SidhantEE/rubiks-cube-solver/cad/stl/drive_adapter_set.stl

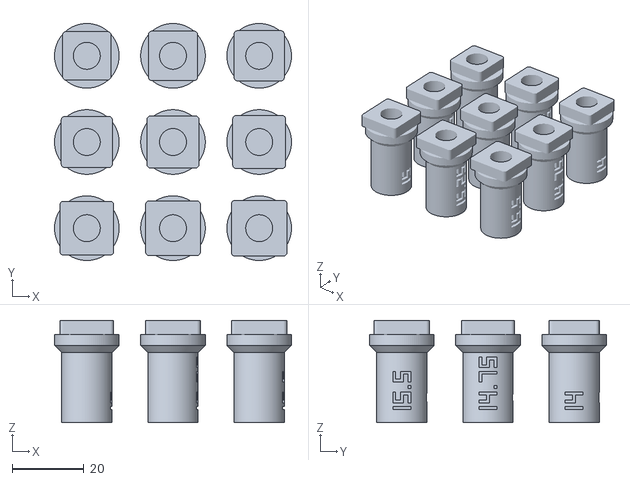
[picture p1: CAD file, 2026-11-10]
cad/stl/drive_adapter_set.stl
66.0 x 66.0 x 28.5
