SidhantEE/rubiks-cube-solver/cad/stl/drive_adapter_PLACEHOLDER_15mm_tip.stl

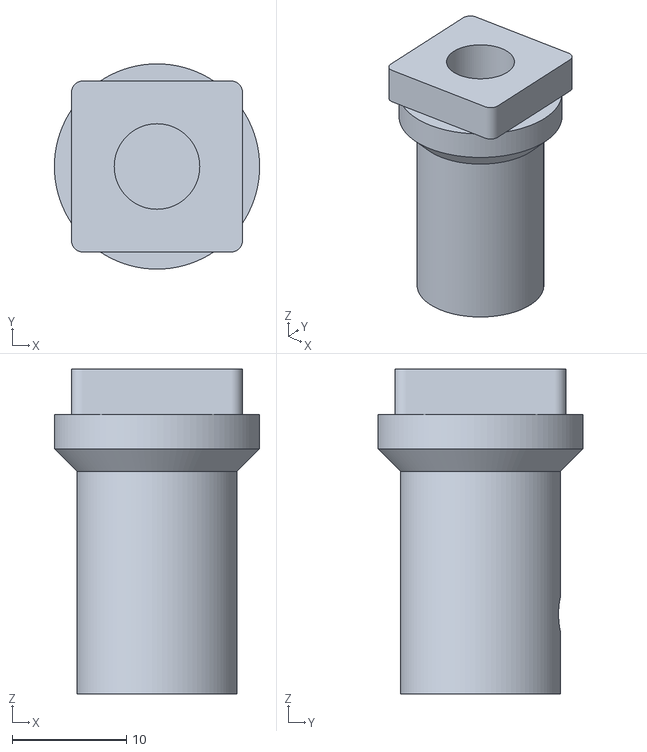
[picture p2: CAD file, 2026-11-10]
cad/stl/drive_adapter_PLACEHOLDER_15mm_tip.stl
18.0 x 18.0 x 28.5
