SidhantEE/rubiks-cube-solver/cad/stl/frame_top.stl

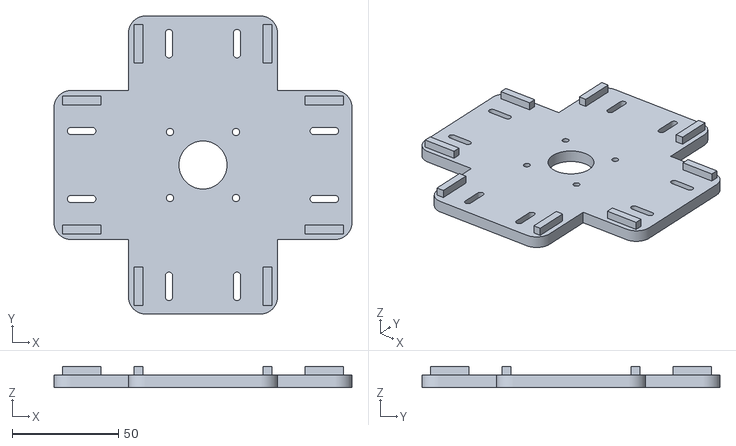
[picture p3: CAD file, 2026-11-10]
cad/stl/frame_top.stl
140.0 x 140.0 x 10.0
