SidhantEE/rubiks-cube-solver/cad/stl/bench_stand.stl

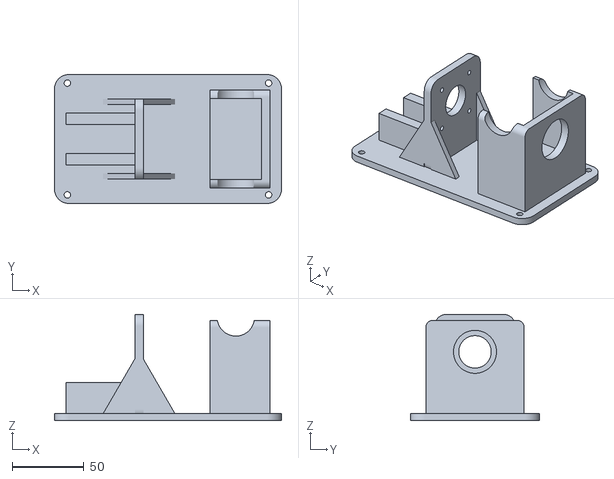
[picture p4: CAD file, 2026-11-10]
cad/stl/bench_stand.stl
158.4 x 90.0 x 74.2
