SidhantEE/rubiks-cube-solver/cad/stl/frame_tower.stl

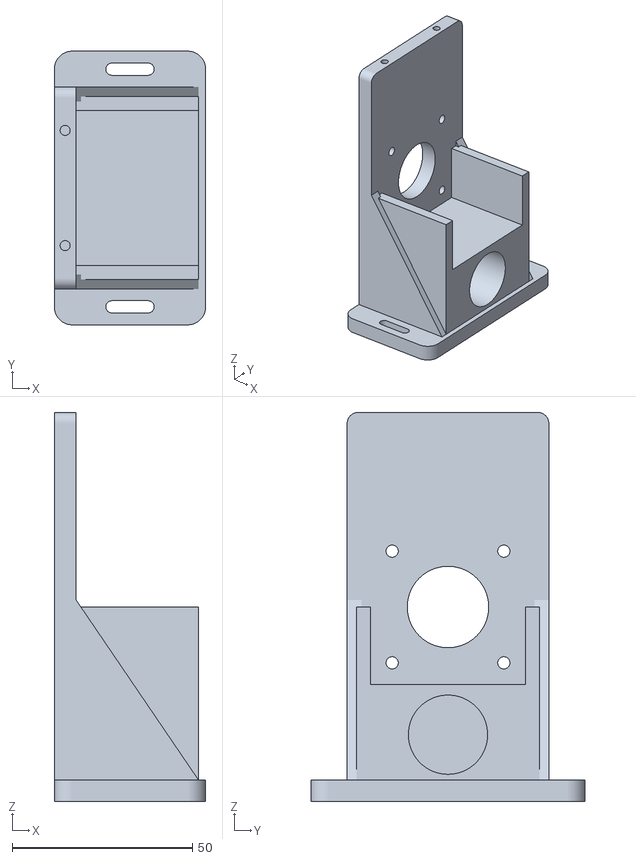
[picture p5: CAD file, 2026-11-10]
cad/stl/frame_tower.stl
42.0 x 76.0 x 108.0
