SidhantEE/rubiks-cube-solver/cad/stl/frame_base.stl

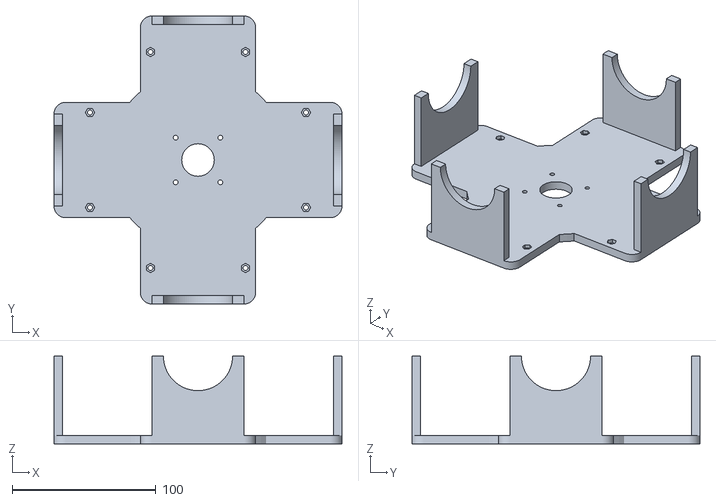
[picture p6: CAD file, 2026-11-10]
cad/stl/frame_base.stl
200.0 x 200.0 x 61.0
