SidhantEE/rubiks-cube-solver/docs/build-plan.html

Research summary and bill of materials · 9 Nov 2026

# What it takes to build a fast Rubik's cube solver

We are building Tier 1: six StepperOnline 17HE19-2004S stepper motors on TMC5160 drivers, about $440 to $460 in parts plus your own 24 V supply, aiming for a solve of 1 to 1.5 seconds. On paper the motor handles 40 to 45 ms quarter turns at 24 V.

The feasibility check is a calculation, not a measurement. No published cube robot names this exact motor, and cube friction is the main unknown. A one-axis bench test settles it before all six axes are built. The parts list below was audited on 10 Nov 2026.

## Where each machine sits

Purdue, Purdubik's Cube (2025)0.103 s

Mitsubishi TOKUFASTbot (2024)0.305 s

MIT, Katz and Di Carlo (2018)0.38 s

Sub1 Reloaded (2016)0.637 s

Flatland and Rose, steppers (2016)0.900 s

Hackaday build, Aaed Musa (2023)4.56 s

Tier 1, steppers (our build)1 to 1.5 s

Tier 2, brushless servos0.3 to 0.6 s

Tier 3, industrial servos0.1 to 0.15 s

0.1 s0.20.5125 s

Logarithmic scale. Dots are recorded times. Blue bands are estimated ranges for the three build tiers below.

## Tier 1 motor choice

The pick is the StepperOnline 17HE19-2004S, chosen on price. At $6.36 it is the cheapest of the four, and it has lower winding inductance than the motor the Hackaday build used. Inductance is what starves a stepper of torque at speed. The LDO is the faster motor at five times the price.

Motor | Holding torque | Current | Inductance | Rotor inertia | Price each
StepperOnline 17HE19-2004S (chosen) | 0.55 Nm | 2.0 A | 2.4 mH | 62 g·cm² | $6.36
StepperOnline 17HS19-2004S1 (Hackaday motor) | 0.59 Nm | 2.0 A | 3.0 mH | 82 g·cm² | $9.62
LDO-42STH48-2504AC | 0.55 Nm | 2.5 A | 1.5 mH | 84.5 g·cm² | $32.99
ADI Trinamic QSH4218-47-28-040 | 0.40 Nm | 2.8 A | 0.6 mH | 68 g·cm² | about $60
StepperOnline 23HS22-2804S (NEMA 23) | 1.26 Nm | 2.8 A | 2.5 mH | not found | about $25

Specs are from the manufacturers' pages and spec sheets. StepperOnline and LDO prices were read from the store pages on 9 Nov 2026; StepperOnline prices ship from China, and US stock adds about $2 to $3.50 a motor. The Trinamic price is for a sibling model at Mouser. All three NEMA 17 motors share the same 42 mm body, 48 mm length and 5 mm shaft, so printed parts fit any of them.

### Which motors have been documented in a cube solver

- 17HS19-2004S1: yes. The Hackaday build's parts list links to this exact motor. It solved in 4.56 s, held back by weak TMC2208 drivers and a 75-move solver.
- 17HE19-2004S (our pick): no cube solver names it. It is common in hobby CNC builds. Its wire colours differ from the 17HS19, and one builder had to swap the blue and green wires.
- LDO-42STH48-2504AC: no cube solver names it. It is a standard high-speed 3D-printer motor.
- Other fast stepper robots (0.900 s and 1.5 to 2 s) do not publish their motor models.

## Will it work?

### Yes on paper, for quarter turns of 40 ms and slower at 24 V

At 24 V the 17HE19-2004S has roughly 1.5 to 2.6 times the torque a 40 ms quarter turn needs. At 35 ms it has no margin on 24 V, but a 35 V supply restores it. About 20 moves at 40 to 45 ms is 0.8 to 0.9 s of motion.

### Torque needed against torque available

Quarter turn | Peak speed | Torque needed | Available at 24 V | Available at 35 V | Verdict
50 ms | 600 rpm | 0.10 to 0.20 Nm | 0.47 Nm | 0.55 Nm | comfortable
45 ms | 667 rpm | 0.12 to 0.22 Nm | 0.41 Nm | 0.55 Nm | comfortable
40 ms | 750 rpm | 0.13 to 0.23 Nm | 0.34 Nm | 0.55 Nm | works at 24 V
35 ms | 857 rpm | 0.16 to 0.26 Nm | 0.26 Nm | 0.51 Nm | needs about 35 V
30 ms | 1,000 rpm | 0.20 to 0.30 Nm | 0.17 Nm | 0.41 Nm | marginal at 35 V

My calculation. Assumes a cube layer of 150 g·cm² (a commenter's estimate on the MIT build log, close to my own), friction of 0.05 to 0.15 Nm (a guess), and a move that accelerates for half the turn and brakes for the other half. "Available" is the theoretical pull-out torque at peak speed; an open-loop stepper should stay well under it. The rotor inertia is 62 g·cm², from the motor's datasheet. The cube weighs 88.9 g, which puts one layer at roughly 145 g·cm², in line with the 150 used here. For comparison at 40 ms on 24 V, the same sum gives the LDO 0.48 Nm and the Hackaday motor 0.27 Nm.

### Evidence from other builds

- Same timing has been done with steppers. Flatland and Rose's 0.900 s record robot used six steppers at 50 full steps per quarter turn. Their published timing tables give 35 ms per quarter turn and 56 ms per half turn at the fastest setting, about 0.90 s for 25 moves. Their motor model is not published.
- Generic steppers reach 1.5 to 2 s. iBoot32's 2022 robot did that with DRV8825 drivers, which are weaker than the TMC5160.
- Too little torque fails outright. A University of Illinois team's 0.10 Nm NEMA 14 motors could not turn a face at all. Our motor has 5.5 times that at standstill.
- No precedent for this exact motor. I read nine hobby cube robots and searched by part number. None names the 17HE19-2004S, and most name no motor.

### What could still stop it

- Cube friction. Nobody publishes a measured turning torque for a speed cube. A cube tensioned tight enough not to deform may need more than my 0.15 Nm upper guess.
- Lock-ups. If one face stops a few degrees off, the next turn jams. An open-loop stepper then loses steps without knowing. The MIT team blew drive transistors this way.
- Driver heat. The TMC5160 board needs a fan above 2 A. This motor runs at 2.0 A, right at that limit, and you have chosen to run without a fan. If a driver overheats it cuts the motor current, which shows up as missed turns in long runs.
- Driver voltage ceiling. The standard TMC5160 board stops at 35 V, so a 36 V supply must be trimmed down to about 33 V.

## What actually sets the solve time

Solve time is roughly the number of moves multiplied by the time per move, plus a few tens of milliseconds for the camera and solver. Both factors differ by about a factor of ten between the Hackaday build and the record.

Machine | Solver | Moves | Per quarter turn | Actuator
Hackaday build | CFOP (human method) | 50 to 75 | about 92 ms | Open-loop NEMA 17 stepper, one at a time
MIT 2018 | min2phase | 19 to 23 | 10 ms, one every 15 ms | Kollmorgen ServoDisc, 2000-line encoder, 40 V
Mitsubishi 2024 | Proprietary | about 15 | 9 ms | Mitsubishi servomotors, model not published
Purdue 2025 | rob-twophase | not published | about 5.5 ms (my estimate) | Kollmorgen AKM2G-24F

- Solver: switching from CFOP to a two-phase solver cuts 75 moves to about 20. It is free software and the largest single gain.
- Parallel moves: rob-twophase counts opposite faces turning together as one move, averaging about 15 moves, found within 10 ms.
- Torque over inertia: quarter-turn time depends on how hard the motor can accelerate its own rotor plus one cube layer. This is where steppers lose.
- Corner cutting: starting the next face before the last one has stopped. It needs closed-loop position feedback and breaks cubes when mistimed.
- The cube: at record speed, stock cubes snap. Purdue used a custom SLS nylon core tensioned too tight to turn by hand.

## The record machine, part by part

Part | What Purdue used | Confidence
Motors | 6× Kollmorgen AKM2G-24F | One trade article names it; its quoted 3,400 rpm matches the datasheet
Drives | Kollmorgen AKD2G | Kollmorgen's own promotion; exact variant not published
Controller | Kollmorgen PCMM2G | Kollmorgen's own promotion
Cameras | 2× Flir machine vision, 10 µs exposure, 128×124 px crop | One article; model not published
Colour reading | Raw RGB values, no image processing | One article
Solver | rob-twophase (Elias Frantar) | One article, links the repo
Cube | Custom SLS nylon core, lubricated, very high tension | Two articles
Motion | Trapezoidal profile, about 12 million °/s², corner cutting | One article
Compute, 103 ms breakdown | Not published | Not found

### AKM2G-24F datasheet figures

Frame | 58 mm flange, about 2.0 kg
Continuous stall torque | 1.86 Nm
Peak torque | 7.24 Nm
Rotor inertia | 0.279 kg·cm²
Peak torque ÷ rotor inertia | about 260,000 rad/s² (15 million °/s²)
Rated speed | 3,400 rpm at 120 VAC, 7,200 rpm at 240 VAC
Max mechanical speed | 8,000 rpm
Paired drive in the guide | AKD2G-SPx-6V06 (6 A, 120/240 VAC)

From Kollmorgen's AKM2G selection guide. The trade article calls the motors "low-voltage" and quotes 5.97 Nm, but the low-voltage catalogue has no F winding and 5.97 Nm belongs to the 24PL. I believe the model is right and that label is wrong.

## Three build tiers

listed price seen on a seller page this week estimate my rough figure, check before buying unknown no price found

### Tier 1: stepper build (chosen)

target 1 to 1.5 s · about $440 to $460

The Hackaday layout with stronger drivers, a two-phase solver, a real speed cube and cameras. At 40 to 45 ms per quarter turn and about 20 moves, motion takes 0.8 to 0.9 s. This list was audited on 10 Nov 2026 against the carts and the parts' own datasheets.

### Ordered

Item | Qty | Each | Subtotal | Price basis
StepperOnline 17HE19-2004S stepper motor, US warehouse | 6 | $8.45 | $50.70 | seen in your StepperOnline checkout
StepperOnline packing fee | | | $1.90 | seen in your StepperOnline checkout
TMC5160 SilentStepStick driver | 7 | $19.20 | $134.40 | seen in your Mouser cart; six for the build, one spare
Teensy 4.1 with headers (SparkFun DEV-16996) | 1 | $35.95 | $35.95 | seen in your Mouser cart
Jumper wires, 6", packs of 20 (male-female and female-female) | 2 | $2.75 | $5.50 | seen in your Mouser cart
22 AWG stranded wire, black, 25 ft | 1 | $5.95 | $5.95 | seen in your Mouser cart
Mouser estimated tariff | | | $12.88 | seen in your Mouser cart
Mouser UPS Ground shipping | | | $9.39 | seen in your Mouser cart
YJ YuLong V2 M speed cube | 1 | $8.99 | $8.99 | listed price I did not see how many you ordered
Cubicle Silicone Lube, Weight 3, 5cc | 1 | $3.89 | $3.89 | listed price I did not see it in a cart
Ordered subtotal | | | $269.55

I saw the carts but not the final orders, so three things may differ. If you swapped to the motor 5-pack plus one single, motors are about $6.78 less. If you added the red wire, add $5.95. Shipping from StepperOnline and TheCubicle, and sales tax, are not included.

### Still to buy

Item | Qty | Subtotal | Price basis
100 µF 50 V capacitors, one per driver | 7 | $3 to $5 | estimate
M3 screws: 24 × 10 mm for the motors, 6 × 6 mm for the adapters | 1 box | $8 to $10 | estimate an assortment box covers both
Screw terminals or protoboard for the 24 V wiring | 1 | $5 to $10 | estimate
Micro-USB cable for the Teensy | 1 | $0 to $5 | estimate the board does not include one
Printed bench stand, UTA FabLab | 1 | about $5 | estimate from the model at $0.05 per gram
Printed six-motor frame and six shaft adapters | 1 set | $15 to $17 | estimate from the models at $0.05 per gram
Arducam colour global-shutter USB camera (OV9782) | 2 | $120 | estimate mono version listed at $60
LED lighting for the cameras | 1 | $10 to $15 | estimate
24 V power supply, about 10 A for six motors | 1 | not included | You are supplying this
Still-to-buy subtotal | | $166 to $187
Whole Tier 1 build | | $436 to $457 | Without cameras and lighting: $306 to $322

### What the audit changed

- Drivers: six became seven, matching what is in the cart.
- Fan: removed, as you decided it is not needed.
- Motor price: now the $8.45 US-warehouse price from your checkout, plus the packing fee.
- Added: Mouser's tariff and shipping, the wires, the lube, M3 screws, a USB cable and the printed parts. None of these were in the earlier list.
- Split in two: the old single "wiring and lighting" and "frame and fasteners" estimates are now separate lines.

### Checks against the parts' own documents

- Motor: the 17HE19-2004S datasheet confirms 0.55 Nm, 2.0 A, 1.30 Ω, 2.40 mH, a 62 g·cm² rotor and 0.27 kg. Its drawing confirms a 5 mm shaft 24 mm long with a 15 mm flat, M3 holes on a 31 mm square and a 22 mm boss.
- Motor cable: 1 m of 24 AWG wire ending in a 4-pin 2.54 mm plug. The wires run B−, A−, B+, A+, which does not match the driver's pin order, where each coil's two pins sit together. Two pins have to be moved in the plug before it goes on the driver.
- Driver and motor: the driver's 3 A and 10 to 35 V limits cover the motor's 2.0 A on a 24 V supply.
- Driver and Teensy: both use 3.3 V logic. The driver must be set up over SPI.
- Firmware: the Teensy sketch in the repository sets each driver to 2.0 A over SPI, uses 8 microsteps (400 steps per quarter turn) and turns opposite faces together. It passes a simulated test on a computer; it has not run on real hardware.
- Driver header pins: I have not confirmed whether the board arrives with its pins soldered. Plan on a soldering iron being needed.
- Cube: TheCubicle lists it at 56.0 mm and 88.9 g, magnetic.

### Where to buy

Part | Mouser | Otherwise
Teensy 4.1 | Yes. With headers (DEV-16996) is $35.95, 361 in stock. The bare board (DEV-16771) is restricted. | SparkFun, $31.50 for the bare board
TMC5160 SilentStepStick | Yes, 620 in stock; Mouser will drop it when stock runs out | DigiKey
Mean Well LRS-350-24 | Yes, 362 in stock | Bravo Electro, Jameco
17HE19-2004S motor | No. Mouser carries no StepperOnline parts | StepperOnline direct, or its Amazon store
Arducam camera | Not found | Arducam, RobotShop
Speed cube, filament, fasteners, magnets | No | Cube shops, Amazon, hardware suppliers

The drivers, the Teensy and a power supply can come from Mouser. The motors, cube and cameras cannot. Its own NEMA 17 motors start at $32.81 and are low-current types that suit this job poorly. Mouser stock and prices were read from the live pages on 9 Nov 2026.

### Tier 2: brushless servo build

target 0.3 to 0.6 s · about $1,300 to $2,100

The MIT approach with current off-the-shelf parts: six brushless motors with encoders and closed-loop field-oriented drivers. The motor choice below is a starting point. Its rotor inertia is not published where I looked, so one axis needs testing before buying six.

Item | Qty | Each | Subtotal | Price basis
mjbots mj5208 brushless motor | 6 | $74 | $444 | listed reseller
moteus-c1 controller (or moteus-n1 at $149) | 6 | $69 to $149 | $414 to $894 | listed reseller
CAN-FD USB adapter | 1 | $100 | $100 | estimate
48 V supply, 600 to 1,000 W, plus bulk capacitors | 1 | $60 to $120 | $60 to $120 | estimate
Colour global-shutter USB camera | 2 | $60 | $120 | estimate
Speed cubes (expect to break several) | 5 | $10 to $20 | $50 to $100 | estimate
Square drives and shaft couplers | 6 | | $40 to $100 | estimate
Rigid frame, aluminium plate or extrusion | 1 | | $100 to $200 | estimate
Total | | | $1,328 to $2,078

Alternative drivers: ODrive Micro at $89 or ODrive Pro at $229 each (listed). A one-axis starter is the moteus-c1 developer kit at $149 (listed), which includes one mj5208 motor.

### Tier 3: industrial servos, the record recipe

target 0.1 to 0.15 s · $33,000 and up

The Purdue hardware. Students built it with corporate sponsorship and co-op earnings, and it also needs a custom cube core.

Item | Qty | Each | Subtotal | Price basis
Kollmorgen AKM2G-24F motor | 6 | about $2,475 | about $14,850 | estimate reseller price of the older AKM24D
Kollmorgen AKD2G-SPE-6V06S drive | 6 | $3,035 | $18,210 | listed reseller
Kollmorgen PCMM2G controller | 1 | | | unknown
Flir machine-vision cameras | 2 | | | unknown model not published
Custom SLS nylon cube core, machined shafts, frame | 1 | | | unknown
Motors and drives only | | | about $33,060

## What I would do

### Build Tier 1, and bench-test one axis before buying six motors

The solver, camera reading, move scheduler and cube handling are the same work at every tier. Building them on steppers gets a working machine near 1 second, and a later brushless upgrade replaces only the actuators and their drivers.

1. Solver on your computer. Build rob-twophase and get from a scramble to a move list. Free, and it works before any hardware arrives.
2. One axis on a bench. One 17HE19-2004S motor and one TMC5160 on 24 V, turning one face of a tensioned speed cube. Start at 60 ms per quarter turn and shorten it until steps are lost. If it holds 40 to 45 ms, order the other five.
3. Six axes with manual entry. Frame, six motors, a move scheduler. Type in the cube state and solve it.
4. Parallel opposite faces. Run the two motors on an axis together, using the solver's axial mode.
5. Cameras. Two cameras at opposite corners, fixed lighting, fixed pixel regions per sticker.
6. Then upgrade actuators. Buy one brushless motor and driver, repeat the one-axis test, and only then buy the other five.

## Open questions

- Cube turning torque. Unmeasured. It is the largest uncertainty in the Tier 1 feasibility check.
- How the motor grips the cube. Printed centre-cap adapters as in the Hackaday build, or metal square drives pressed into the centre recess as MIT did. Not yet decided.
- Tools you have. A 3D printer covers Tier 1. Tier 2 wants metal square drives and a stiff frame.
- Tier 2 motor inertia. I did not find a rotor inertia figure for the mj5208, so its quarter-turn time is untested.
- Unread sources. Kollmorgen's site, The Verge and Design News blocked automated reading. The Verge article is the likeliest to hold more Purdue detail.
- Prices. Most Tier 1 prices and several Tier 2 prices are my estimates. Reseller prices for Kollmorgen parts are not official list prices.

## Sources

- Hackaday: Rubik's Cube Solver (Aaed Musa) (https://hackaday.io/project/190071-rubiks-cube-solver)
- Purdue ECE announcement (https://engineering.purdue.edu/ECE/news/2025/purdue-ece-students-shatter-guinness-world-record-for-fastest-puzzle-cube-solving-robot)
- Designfax: names the AKM2G-24F (https://www.designfax.net/cms/dfx/opens/article-view-dfx.php?nid=4&bid=1534&et=featurearticle&pn=02)
- Micromech/Kollmorgen PACK EXPO write-up (https://www.micromech.co.uk/worlds-fastest-rubiks-cube-solve-powered-by-kollmorgen/)
- Kollmorgen AKM2G selection guide (PDF) (https://www.micromech.co.uk/wp-content/uploads/2026/03/akm2g_selection_guide.pdf)
- Kollmorgen AKM2G low-voltage catalogue (PDF) (https://www.micromech.co.uk/wp-content/uploads/2026/03/akm2g_lowvoltage_catalogue.pdf)
- ZME Science: cameras, solver, cube core (https://www.zmescience.com/science/news-science/robot-rubik-cube-record/)
- Popular Science (https://www.popsci.com/technology/fastest-rubiks-cube-robot/)
- heise online (https://heise.de/-10385648)
- Purdue Engineering video (https://www.youtube.com/watch?v=sXxh6QuY2ew)
- MIT build log: The Rubik's Contraption (https://build-its-inprogress.blogspot.com/2018/03/the-rubiks-contraption.html)
- MIT motor controller firmware (https://os.mbed.com/users/benkatz/code/rubix_controller/)
- rob-twophase solver (https://github.com/efrantar/rob-twophase)
- Mitsubishi TOKUFASTbot case study (https://www.cc-link.org/en/usecases/cclinkie_tsn_mitsubishielectric.html)
- Live Science: Sub1 Reloaded (https://www.livescience.com/56828-robot-sets-rubiks-cube-world-record.html)
- StepperOnline 17HE19-2004S (https://www.omc-stepperonline.com/e-series-nema-17-bipolar-55ncm-77-88oz-in-2a-42x48mm-4-wires-w-1m-cable-connector-17he19-2004s)
- StepperOnline 17HS19-2004S1 (https://www.omc-stepperonline.com/nema-17-bipolar-59ncm-84oz-in-2a-42x48mm-4-wires-w-1m-cable-connector-17hs19-2004s1)
- V1 Engineering thread on 17HE19-2004S wiring (https://forum.v1e.com/t/stepper-motor-config-17he19-2004s/42409)
- Hackaday build parts list (spreadsheet) (https://cdn.hackaday.io/files/1900718131997664/Bill%20of%20Materials.xlsx)
- TMC5160 SilentStepStick at Mouser (https://www.mouser.com/en/ProductDetail/Analog-Devices-Maxim-Integrated/TMC5160SilentStepStick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)
- Teensy 4.1 at SparkFun (https://www.sparkfun.com/teensy-4-1.html)
- YJ YuLong V2 M at TheCubicle (https://www.thecubicle.com/products/yj-yulong-v2-m)
- LDO motor at BIQU (https://biqu.equipment/products/ldo-42sth48-2504ac-reva-motor-driver)
- LDO-42STH48-2504AC spec sheet (PDF) (https://kb-3d.com/store/index.php?controller=attachment&id_attachment=6)
- LDO-42STH48-2504AC product page (https://ldomotion.com/products/ldo42sth482504ac)
- LDO motor at KB-3D (https://kb-3d.com/store/stepper-motors-servos/371-ldo-stepper-motor-nema-17-42sth48-2504ac-speedy-power-1651971790651.html)
- LDO motor at DFH (https://dfh.fm/products/ldo-nema-17-motor-ldo-42sth48-2504ac-dfh)
- 17HS19-2004S1 datasheet (PDF) (https://static.maritex.eu/file/display/5sXxpHH1SP-JwnhJEZ0lhfX-xdYKZRi3/17HS19-2004S1_Full_Datasheet.pdf)
- QSH4218-47-28-040 at DigiKey (https://www.digikey.com/en/products/detail/trinamic-motion-control-gmbh/QSH4218-47-28-040/5972705)
- Flatland and Rose robot: code and timing tables (https://github.com/bilson/HighFrequencyTwister)
- Hackaday on the Flatland and Rose robot (https://hackaday.com/2016/01/27/robot-solves-rubiks-cube-in-just-one-second/)
- iBoot32's 1.5 to 2 s robot (https://blog.arduino.cc/2022/08/01/arduino-controlled-robot-solves-rubiks-cubes-in-a-couple-seconds/)
- University of Illinois report: motors too weak (PDF) (https://courses.grainger.illinois.edu/ece445/getfile.asp?id=6925)
- TMC5160 SilentStepStick limits (https://learn.watterott.com/silentstepstick/comparison/)
- TMC5160 SilentStepStick at DigiKey (https://www.digikey.com.au/en/products/detail/analog-devices-inc-maxim-integrated/TMC5160SILENTSTEPSTICK/9990281)
- Teensy 4.1 at Mouser (https://www.mouser.com/en/ProductDetail/SparkFun/DEV-16771?qs=vmHwEFxEFR%2FenEKd%2FmWpTA%3D%3D)
- Mean Well LRS-350-24 at Mouser (https://www.mouser.com/ProductDetail/MEAN-WELL/LRS-350-24?qs=ah3jBNVE1PT%2BkwLcackrGA%3D%3D)
- moteus-c1 listing (https://reach.dog/shop/mjbots-robotic-systems/products/moteus-c1)
- mj5208 motor listing (https://reach.dog/shop/mjbots-robotic-systems/products/mj5208)
- ODrive motor controllers (https://shop.odriverobotics.com/collections/motor-controllers)
- AKD2G-SPE-6V06S reseller listing (https://servosupplier.com/products/akd2g-spe-6v06s-a100-0000)
- AKM24D reseller listing (https://servosupplier.com/products/akm24d-ancn2-00)
- Arducam OV9281 camera listing (https://robotshop.com/products/arducam-120fps-global-shutter-usb-camera-board-1mp-ov9281-uvc-m12-lens)
