SidhantEE/rubiks-cube-solver/(commit log)

2026-11-09 Initial scaffold: firmware, solver pipeline, BOM and hardware notes
2026-11-09 Base BOM and hardware docs on the t33devv/rubik build
    Switch to pancake NEMA 17s, A4988 drivers on a breadboard and a
    non-magnetic GAN RS cube, and add the parts the t33devv list leaves
    out (12 V supply, capacitors, filament, webcam). Document A4988
    wiring and Vref setup, and link the reference builds.
2026-11-10 Add build plan, bench stand and six-motor frame CAD
    Research and bill of materials for a stepper-driven cube solver, plus
    parametric Python models that generate the printable parts: a one-motor
    bench test stand, the six-motor frame (base, towers, lift-off top) and
    the shaft adapter. The adapter tip is a placeholder until the cube's
    centre recess is measured.
    [bench_stand.stl, drive_adapter_PLACEHOLDER_15mm_tip.stl, frame_base.stl, frame_top.stl, frame_tower.stl]
2026-11-10 Add CLAUDE.md with project context
    Records the hardware decisions, CAD conventions, what is verified,
    wiring notes and the open work, so a later session can continue
    without re-deriving them.
2026-11-10 Port firmware to Teensy 4.1 and TMC5160, replace the old BOM
    Firmware: rewritten for the ordered hardware. It configures each TMC5160
    over SPI (2.0 A RMS, 8 microsteps, SpreadCycle), plans every move as an
    accelerate-then-brake profile set by a quarter-turn time, and runs
    consecutive moves on opposite faces together. New commands: TURN,
    SETTLE, CURRENT, STATUS. Drivers that lose power are set up again
    before the next move.
    Adds firmware/host_test, which compiles the real sketch against a
    stand-in Arduino API with simulated drivers and checks register values,
    step counts and timing. The sketch has not been compiled for the Teensy
    or run on hardware.
    Docs: docs/BOM.md is replaced with the au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
    [Arduino.h, SPI.h, cube_solver.ino, solver.py, test_main.cpp]
2026-11-10 Add adapter size set, update BOM to the actual orders
    - cad/adapter_set.py prints the drive adapter in nine tip widths
    (13.5 to 15.5 mm), each engraved with its width, for finding the
    fit by trial. build_adapter() now takes the tip width.
    - BOM matches the order lines: motors as a 5-pack plus one, red wire
    added, tariff corrected, jumper wires already owned.
    - hardware/README.md and CLAUDE.md describe the adapter set.
    [drive_adapter_set.stl]
